DrJosh9000/mac2hdmi/mac2vga_schematic.pdf

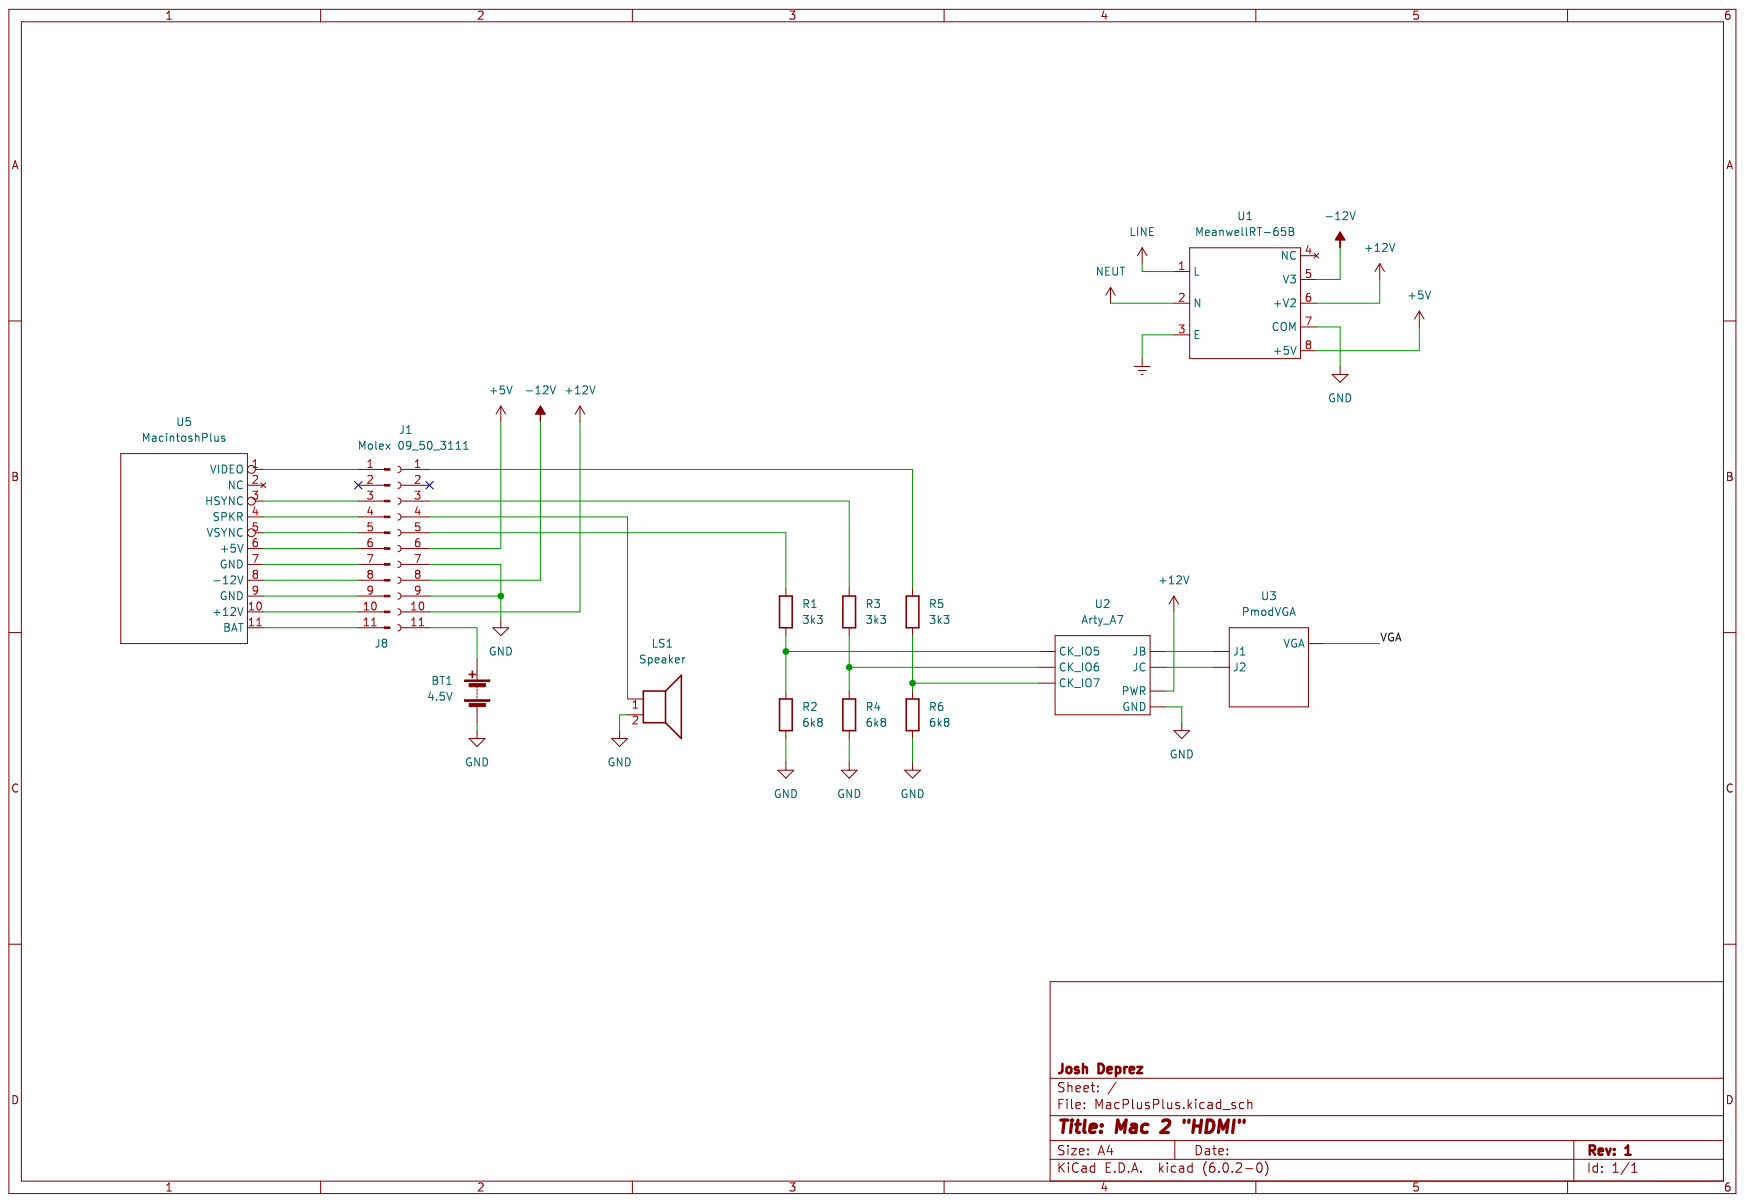
[picture p1: page 1]
