DrJosh9000/mac2hdmi/display_timings.v

`timescale 1ns / 1ps
`default_nettype none

// Project F: Display Timings
// (C)2019 Will Green, Open Source Hardware released under the MIT License
// Learn more at https://projectf.io

// Defaults to 640x480 at 60 Hz

module display_timings #(
    parameter H_RES=640,                      // horizontal resolution (pixels)
    parameter V_RES=480,                      // vertical resolution (lines)
    parameter H_FP=16,                        // horizontal front porch
    parameter H_SYNC=96,                      // horizontal sync
    parameter H_BP=48,                        // horizontal back porch
    parameter V_FP=10,                        // vertical front porch
    parameter V_SYNC=2,                       // vertical sync
    parameter V_BP=33,                        // vertical back porch
    parameter H_POL=0,                        // horizontal sync polarity (0:neg, 1:pos)
    parameter V_POL=0                         // vertical sync polarity (0:neg, 1:pos)
    )
    (
    input  wire i_pix_clk,          // pixel clock
    input  wire i_rst,              // reset: restarts frame (active high)
    output wire o_hs,               // horizontal sync
    output wire o_vs,               // vertical sync
    output wire o_de,               // display enable: high during active video
    output wire o_frame,            // high for one tick at the start of each frame
    output reg signed [15:0] o_sx,  // horizontal beam position (including blanking)
    output reg signed [15:0] o_sy   // vertical beam position (including blanking)
    );

    // Horizontal: sync, active, and pixels
    localparam signed H_STA  = 0 - H_FP - H_SYNC - H_BP;    // horizontal start
    localparam signed HS_STA = H_STA + H_FP;                // sync start
    localparam signed HS_END = HS_STA + H_SYNC;             // sync end
    localparam signed HA_STA = 0;                           // active start
    localparam signed HA_END = H_RES - 1;                   // active end

    // Vertical: sync, active, and pixels
    localparam signed V_STA  = 0 - V_FP - V_SYNC - V_BP;    // vertical start
    localparam signed VS_STA = V_STA + V_FP;                // sync start
    localparam signed VS_END = VS_STA + V_SYNC;             // sync end
    localparam signed VA_STA = 0;                           // active start
    localparam signed VA_END = V_RES - 1;                   // active end

    // generate sync signals with correct polarity
    assign o_hs = H_POL ? (o_sx > HS_STA && o_sx <= HS_END)
        : ~(o_sx > HS_STA && o_sx <= HS_END);
    assign o_vs = V_POL ? (o_sy > VS_STA && o_sy <= VS_END)
        : ~(o_sy > VS_STA && o_sy <= VS_END);

    // display enable: high during active period
    assign o_de = (o_sx >= 0 && o_sy >= 0);

    // o_frame: high for one tick at the start of each frame
    assign o_frame = (o_sy == V_STA && o_sx == H_STA);

    always @ (posedge i_pix_clk)
    begin
        if (i_rst)  // reset to start of frame
        begin
            o_sx <= H_STA;
            o_sy <= V_STA;
        end
        else
        begin
            if (o_sx == HA_END)  // end of line
            begin
                o_sx <= H_STA;
                if (o_sy == VA_END)  // end of frame
                    o_sy <= V_STA;
                else
                    o_sy <= o_sy + 16'sh1;
            end
            else
                o_sx <= o_sx + 16'sh1;
        end
    end
endmodule
