DrJosh9000/mac2hdmi/(commit log)

2022-02-27 The story so far
    [digilent_arty.cfg]
2022-02-27 Fix syntax I messed up while tidying
    [top.v]
2022-02-28 Add schematic of current lab setup
